beggin0516/REspeaker_learn/Designed_Temporary_file/LIB_74AHC1G79GW/74AHC1G79GW/3D/74AHC1G79GW.stp

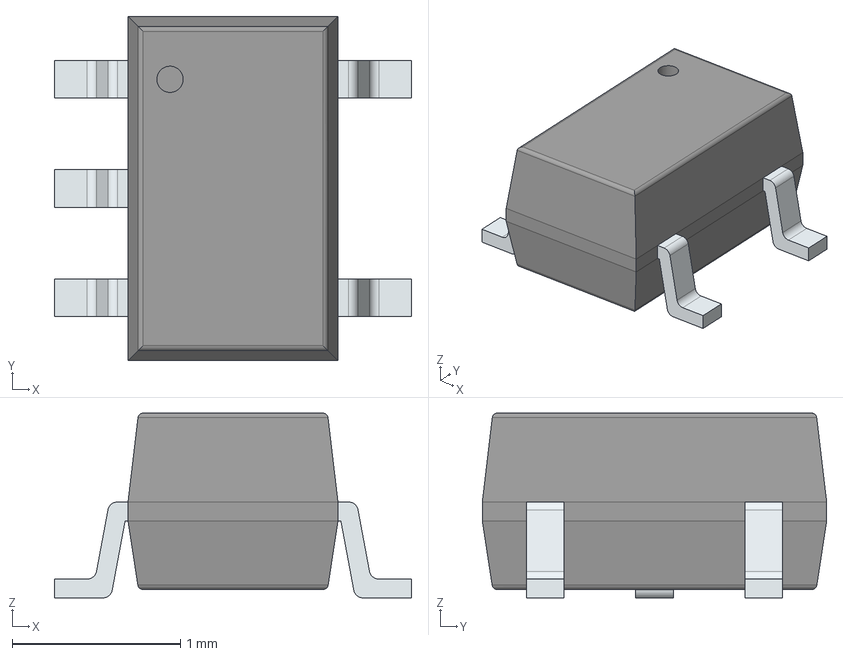
[picture p1: CAD file, 2023-07-12]
Designed_Temporary_file/LIB_74AHC1G79GW/74AHC1G79GW/3D/74AHC1G79GW.stp
2.12 x 2.05 x 1.10 mm
PinsArrayL
PinsArrayR
