beggin0516/REspeaker_learn/Designed_Temporary_file/LIB_74HC1G08GV,125/74HC1G08GV,125/3D/74HC1G08GV,125.stp

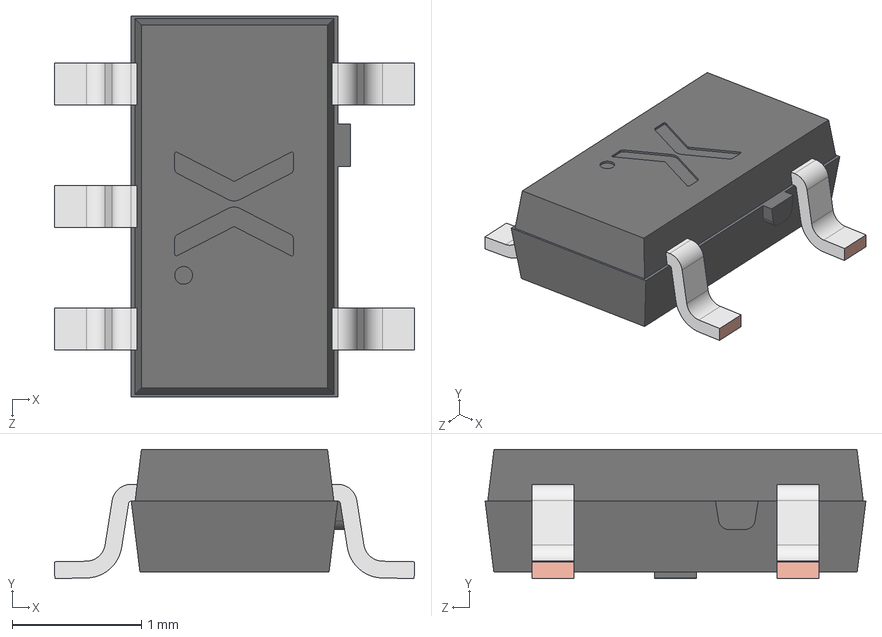
[picture p2: CAD file, 2023-07-15]
Designed_Temporary_file/LIB_74HC1G08GV,125/74HC1G08GV,125/3D/74HC1G08GV,125.stp
2.79 x 1.00 x 2.95 mm
SOT753 Lower mold body
SOT753 Lead x 5
SOT753 Upper mold body
