beggin0516/REspeaker_learn/Designed_Temporary_file/LIB_AP7333-18SAG-7/AP7333-18SAG-7/3D/AP7333-18SAG-7.stp

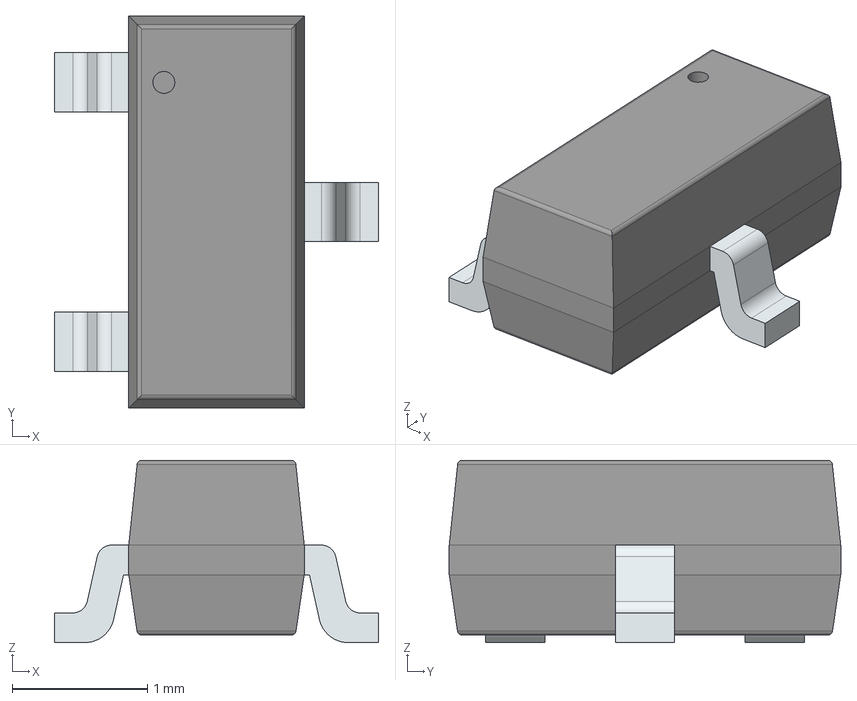
[picture p3: CAD file, 2023-07-12]
Designed_Temporary_file/LIB_AP7333-18SAG-7/AP7333-18SAG-7/3D/AP7333-18SAG-7.stp
2.40 x 2.90 x 1.35 mm
PinsArrayL
FilletPinR
