beggin0516/REspeaker_learn/Designed_Temporary_file/LIB_BLM18BD252SN1J/BLM18BD252SN1J/3D/BLM18BD252SN1J.stp

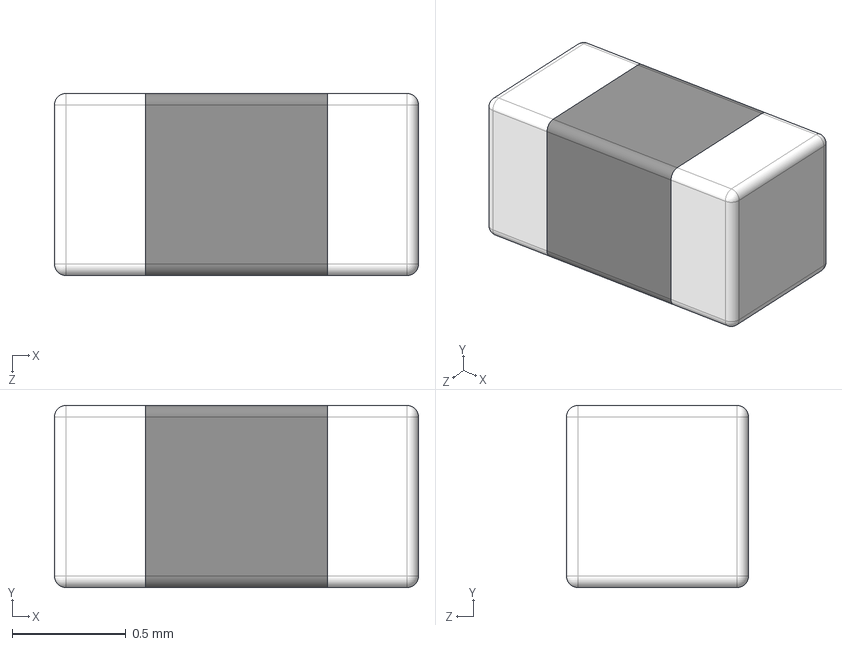
[picture p4: CAD file, 2023-07-12]
Designed_Temporary_file/LIB_BLM18BD252SN1J/BLM18BD252SN1J/3D/BLM18BD252SN1J.stp
1.60 x 0.8 x 0.8 mm
