beggin0516/REspeaker_learn/Designed_Temporary_file/LIB_OXETGLJANF-24MHZ/OXETGLJANF-24MHZ/3D/OXETGLJANF-24MHZ.stp

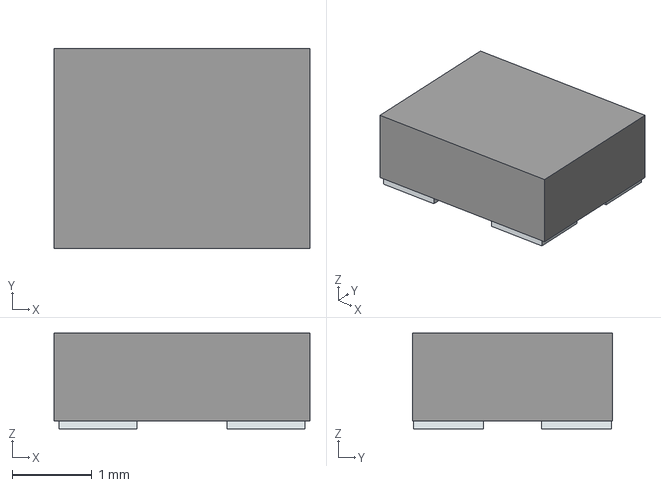
[picture p5: CAD file, 2023-07-12]
Designed_Temporary_file/LIB_OXETGLJANF-24MHZ/OXETGLJANF-24MHZ/3D/OXETGLJANF-24MHZ.stp
3.20 x 2.50 x 1.20 mm
Pins
