beggin0516/REspeaker_learn/Designed_Temporary_file/LIB_WM8960CGEFL_V/WM8960CGEFL_V/3D/WM8960CGEFL_V.stp

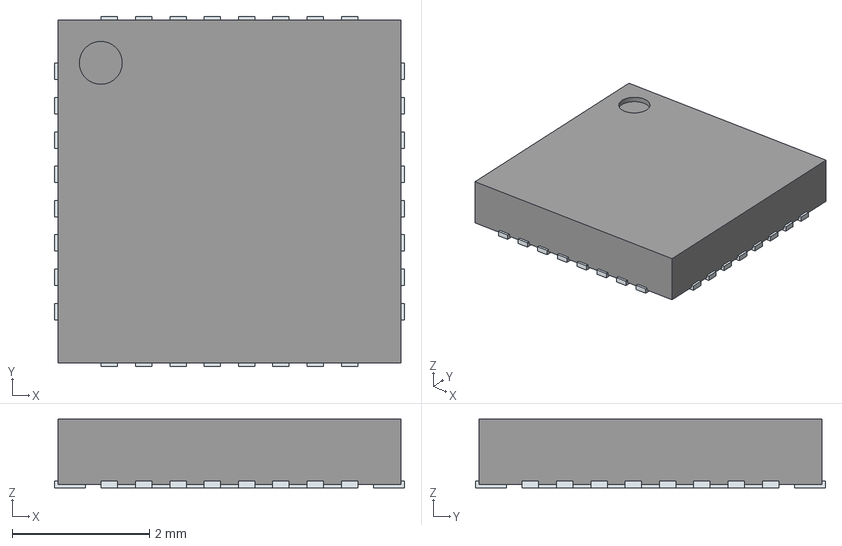
[picture p6: CAD file, 2023-07-12]
Designed_Temporary_file/LIB_WM8960CGEFL_V/WM8960CGEFL_V/3D/WM8960CGEFL_V.stp
5.10 x 5.10 x 1.00 mm
ThermalPin
PinsArrayLR
PinsArrayTB
