beggin0516/REspeaker_learn/(list of files, cad)

Other CAD files:
Designed_Temporary_file/LIB_ADM1085AKS-REEL7/ADM1085AKS-REEL7/3D/ADM1085AKS-REEL7.stp
Designed_Temporary_file/LIB_74AHC1G79GW/74AHC1G79GW/Allegro/sot65p212x110-5n.psm
Designed_Temporary_file/LIB_74AHC1G79GW/74AHC1G79GW/DEHDL/74ahc1g79gw/chips/chips.prt
Designed_Temporary_file/LIB_74HC1G08GV,125/74HC1G08GV,125/Allegro/sot95p275x110-5n.psm
Designed_Temporary_file/LIB_74HC1G08GV,125/74HC1G08GV,125/DEHDL/74hc1g08gv_125/chips/chips.prt
Designed_Temporary_file/LIB_ADM1085AKS-REEL7/ADM1085AKS-REEL7/Allegro/sot65p210x110-6n.psm
Designed_Temporary_file/LIB_ADM1085AKS-REEL7/ADM1085AKS-REEL7/DEHDL/adm1085aks_reel7/chips/chips.prt
Designed_Temporary_file/LIB_AP7333-18SAG-7/AP7333-18SAG-7/Allegro/sot96p240x135-3n.psm
Designed_Temporary_file/LIB_AP7333-18SAG-7/AP7333-18SAG-7/DEHDL/ap7333_18sag_7/chips/chips.prt
Designed_Temporary_file/LIB_BLM18BD252SN1J/BLM18BD252SN1J/Allegro/blm18ag102bh1d.psm
Designed_Temporary_file/LIB_BLM18BD252SN1J/BLM18BD252SN1J/DEHDL/blm18bd252sn1j/chips/chips.prt
Designed_Temporary_file/LIB_ESDPSA0402V05/ESDPSA0402V05/Allegro/esdpsa0402v05.psm
Designed_Temporary_file/LIB_ESDPSA0402V05/ESDPSA0402V05/DEHDL/esdpsa0402v05/chips/chips.prt
Designed_Temporary_file/LIB_FSA2275AUMX/FSA2275AUMX/Allegro/fsa2275aumx.psm
Designed_Temporary_file/LIB_FSA2275AUMX/FSA2275AUMX/DEHDL/fsa2275aumx/chips/chips.prt
Designed_Temporary_file/LIB_OXETGLJANF-24MHZ/OXETGLJANF-24MHZ/Allegro/oxetgljanf24mhz.psm
Designed_Temporary_file/LIB_OXETGLJANF-24MHZ/OXETGLJANF-24MHZ/DEHDL/oxetgljanf_24mhz/chips/chips.prt
Designed_Temporary_file/LIB_WM8960CGEFL_V/WM8960CGEFL_V/Allegro/qfn50p500x500x100-33n.psm
Designed_Temporary_file/LIB_WM8960CGEFL_V/WM8960CGEFL_V/DEHDL/wm8960cgefl_v/chips/chips.prt
Designed_Temporary_file/LIB_XVF3000-TQ128-C/XVF3000-TQ128-C/Allegro/qfp40p1600x1600x120-129n.psm
Designed_Temporary_file/LIB_XVF3000-TQ128-C/XVF3000-TQ128-C/DEHDL/xvf3000_tq128_c/chips/chips.prt
