beggin0516/REspeaker_learn/(list of files, drawings)

Other design files:
Designed_Temporary_file/APA102C/APA102C/SnapEDApcb.PcbLib
Designed_Temporary_file/APA102C/APA102C/SnapEDAsch.SchLib
Designed_Temporary_file/LIB_74AHC1G79GW/74AHC1G79GW/Altium/74AHC1G79GW.SchLib
Designed_Temporary_file/LIB_74AHC1G79GW/74AHC1G79GW/Altium/SOT65P212X110-5N.PcbLib
Designed_Temporary_file/LIB_74HC1G08GV,125/74HC1G08GV,125/Altium/74HC1G08GV_125.SchLib
Designed_Temporary_file/LIB_74HC1G08GV,125/74HC1G08GV,125/Altium/SOT95P275X110-5N.PcbLib
Designed_Temporary_file/LIB_ADM1085AKS-REEL7/ADM1085AKS-REEL7/Altium/ADM1085AKS-REEL7.SchLib
Designed_Temporary_file/LIB_ADM1085AKS-REEL7/ADM1085AKS-REEL7/Altium/SOT65P210X110-6N.PcbLib
Designed_Temporary_file/LIB_AP7333-18SAG-7/AP7333-18SAG-7/Altium/AP7333-18SAG-7.SchLib
Designed_Temporary_file/LIB_AP7333-18SAG-7/AP7333-18SAG-7/Altium/SOT96P240X135-3N.PcbLib
Designed_Temporary_file/LIB_BLM18BD252SN1J/BLM18BD252SN1J/Altium/BLM18BD252SN1J.SchLib
Designed_Temporary_file/LIB_BLM18BD252SN1J/BLM18BD252SN1J/Altium/BLM18EG121SH1D.PcbLib
Designed_Temporary_file/LIB_ESDPSA0402V05/ESDPSA0402V05/Altium/ESDPSA0402V05.PcbLib
Designed_Temporary_file/LIB_ESDPSA0402V05/ESDPSA0402V05/Altium/ESDPSA0402V05.SchLib
Designed_Temporary_file/LIB_FSA2275AUMX/FSA2275AUMX/Altium/FSA2275AUMX.PcbLib
Designed_Temporary_file/LIB_FSA2275AUMX/FSA2275AUMX/Altium/FSA2275AUMX.SchLib
Designed_Temporary_file/LIB_OXETGLJANF-24MHZ/OXETGLJANF-24MHZ/Altium/OXETGLJANF24MHZ.PcbLib
Designed_Temporary_file/LIB_OXETGLJANF-24MHZ/OXETGLJANF-24MHZ/Altium/OXETGLJANF-24MHZ.SchLib
Designed_Temporary_file/LIB_WM8960CGEFL_V/WM8960CGEFL_V/Altium/QFN50P500X500X100-33N.PcbLib
Designed_Temporary_file/LIB_WM8960CGEFL_V/WM8960CGEFL_V/Altium/WM8960CGEFL_V.SchLib
Designed_Temporary_file/LIB_XVF3000-TQ128-C/XVF3000-TQ128-C/Altium/QFP40P1600X1600X120-129N.PcbLib
Designed_Temporary_file/LIB_XVF3000-TQ128-C/XVF3000-TQ128-C/Altium/XVF3000-TQ128-C.SchLib
Designed_Temporary_file/MP34DT01-M/MP34DT01-M/SnapEDApcb.PcbLib
Designed_Temporary_file/MP34DT01-M/MP34DT01-M/SnapEDAsch.SchLib
Designed_Temporary_file/PMIC-ETA3410D2I-T_DFN8-2X2_/PMIC-ETA3410D2I-T_DFN8-2X2_/DFN8G-0.5-2X2MM.PcbLib
Designed_Temporary_file/PMIC-ETA3410D2I-T_DFN8-2X2_/PMIC-ETA3410D2I-T_DFN8-2X2_/PMIC-ETA3410D2I-T(DFN8-2X2).SchLib
Designed_Temporary_file/SMD-RGB-HI-LIGHT_6P-L5.0_W5.0_H1.5MM_/SMD-RGB-HI-LIGHT_6P-L5.0_W5.0_H1.5MM_/LED6-SMD-5050.PcbLib
Designed_Temporary_file/SMD-RGB-HI-LIGHT_6P-L5.0_W5.0_H1.5MM_/SMD-RGB-HI-LIGHT_6P-L5.0_W5.0_H1.5MM_/SMD-RGB-HI-LIGHT(6P-L5.0W5.0H1.5MM).SchLib
led.SchDoc
Microphone.SchDoc
Microphone_array.PcbLib
microphone_array.PrjPcb
microphone_array.SchDoc
Microphone_array.SchLib
Power_interconnect.SchDoc
Sys_Clock.SchDoc
WM8960.SchDoc
X_core_Powerful_pull_up.SchDoc
xCore_Peripheral_pull_up.SchDoc
XVF3000.SchDoc
